rnshmel/AirChat/hardware/production_files/BOM_AirChat_v11.csv

ID | Name | Designator | Footprint | Quantity | Supplier | Supplier Part | Notes
1 | 2.54x1x4 | PROG | HDR-TH_4P-P2.54-V-F | 1 | LCSC | C2718488
2 | FC-D1608HGK-572C | PWR,TX,RX | LED0603-RD | 3 | LCSC | C84264
3 | SMA(F) | ANT | SMA-TH_BWSMA-KE-Z001 | 1 | LCSC | C496549
4 | UBA-4R | USB1 | USB-A-TH_UBA-4R-D14T-4D | 1 | LCSC | C157903
5 | SP0502BAHTG | D1 | SOT-23-3_L2.9-W1.3-P1.90-LS2.4-BR | 1 | LCSC | C207261
6 | 1k | R6 | R0603 | 1 | LCSC | C21190
7 | CP2102N-A02-GQFN20R | U4 | QFN-20_L3.0-W3.0-P0.50-BL-EP1.7_EFM8BB21F16G | 1 | LCSC | C969913
8 | 26MHz | X1 | CRYSTAL-SMD_4P-L3.2-W2.5-BL | 1 | LCSC | C156251
9 | STM32G031F8P6 | U3 | TSSOP-20_L6.5-W4.4-P0.65-LS6.4-BL | 1 | LCSC | C529334
10 | LM1117IMPX-3.3 | U2 | SOT-223_L6.5-W3.5-P2.30-LS7.0-BR | 1 | LCSC | C23984
11 | TICC1101 | U1 | QFN-20_L4.0-W4.0-P0.5-TL-EP | 1 | LCSC | C29953
12 | TS-1102SD-C-C-B | RESET | SW-SMD_4P-L6.0-W6.0-P4.50-LS9.2 | 1 | LCSC | C2935209
13 | 56k | R5 | R0603 | 1 | LCSC | C23206
14 | 4.7k | R4 | R0603 | 1 | LCSC | C23162
15 | 330 | R3,R2,R1 | R0603 | 3 | LCSC | C23138
16 | 18nH | L132 | L0402 | 1 | LCSC | C908004 | wire wound
17 | 12nH | L131,L124,L123,L121 | L0402 | 4 | LCSC | C82920 | wire wound
18 | 3.3nH | L125 | L0402 | 1 | LCSC | C237574 | wire wound
19 | 18nH | L122 | L0402 | 1 | LCSC | C908004 | wire wound
20 | 1.5pF | C131,C122 | C0402 | 2 | LCSC | C880756 | NP0
21 | 47pF | C126 | C0402 | 1 | LCSC | C384800 | NP0
22 | 12pF | C125 | C0402 | 1 | LCSC | C172821 | NP0
23 | 100pF | C124 | C0402 | 1 | LCSC | C431654 | NP0
24 | 3.3pF | C123 | C0402 | 1 | LCSC | C314280 | NP0
25 | 1pF | C121 | C0402 | 1 | LCSC | C323585 | NP0
26 | 27pF | C13,C12 | C0603 | 2 | LCSC | C107045 | NP0
27 | 100nF | C15,C11,C10,C9,C8,C7,C6,C5,C4 | C0603 | 8 | LCSC | C14663
28 | 10uF | C2,C1 | CASE-A_3216 | 2 | LCSC | C7171
29 | 4.7uF | C14,C3 | C0603 | 2 | LCSC | C19666
