rnshmel/AirChat/hardware/Schematic_AirChat_v11.pdf

5VDC to 3.3VDC | SWD (PROG) | TX, RX, PWR LEDs and RST Button

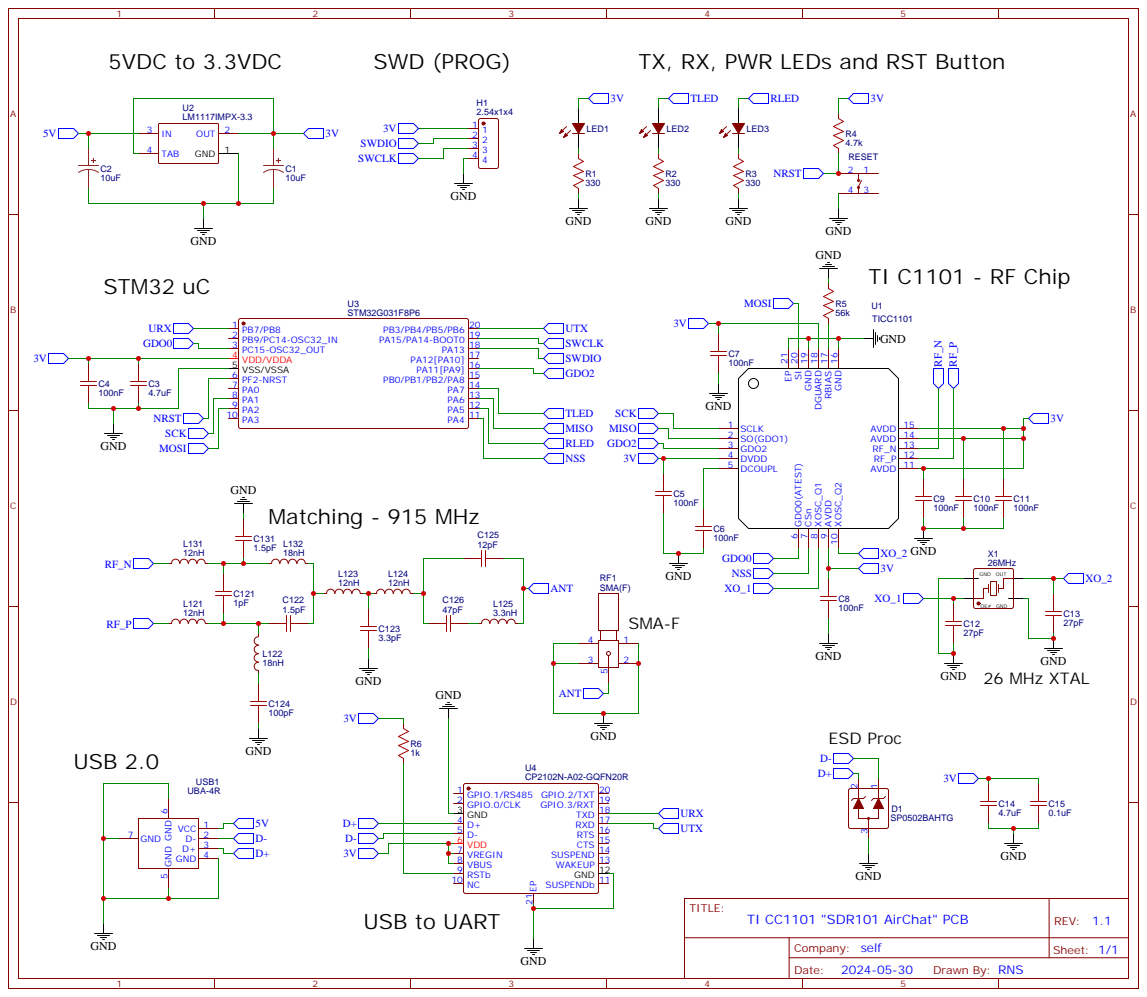
[picture p6: page 1]

GND 16 RBIAS 17 DGUARD 18 GND 19 SI 20 EP 21
