rnshmel/AirChat/hardware/bottom_copper_ACv11.pdf

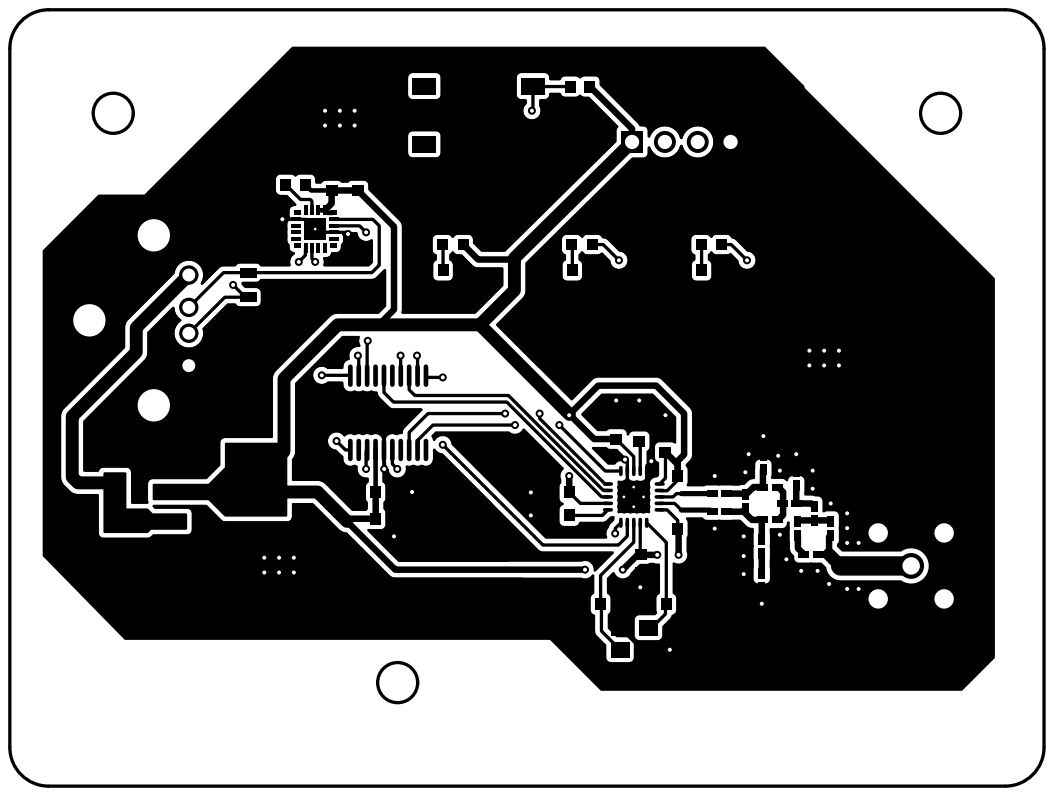
[picture p7: page 1]
