rnshmel/AirChat/hardware/top_copper_ACv11.pdf

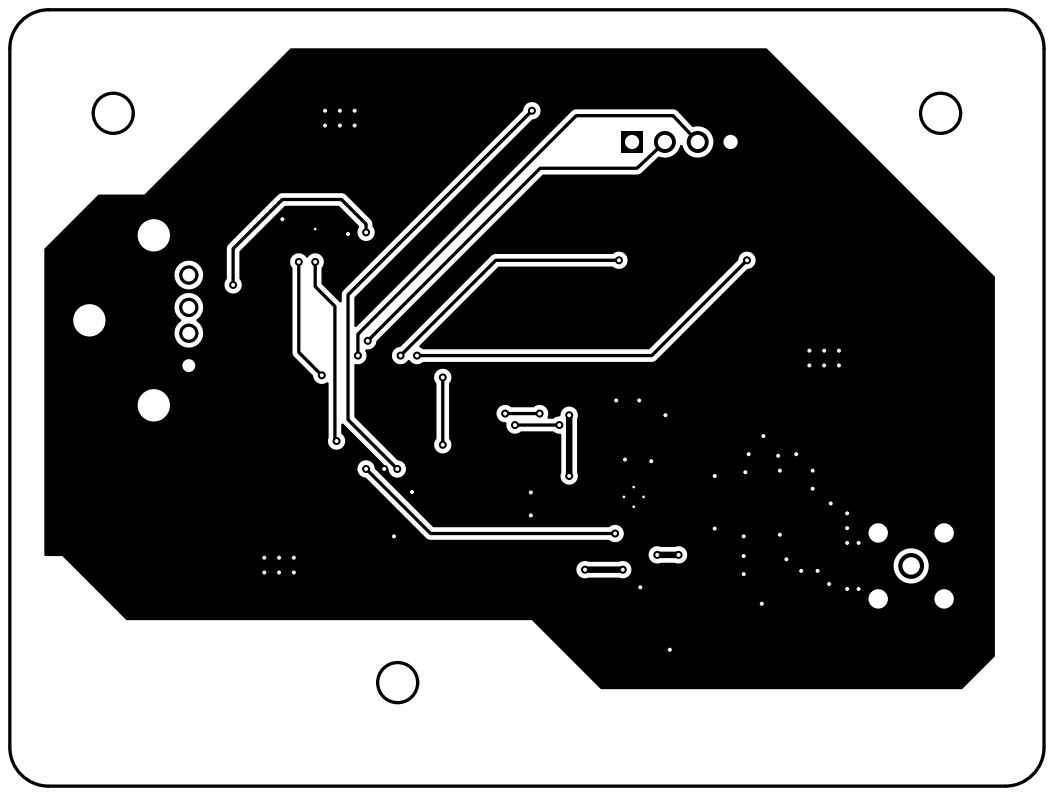
[picture p8: page 1]
